jnedbal/TCXOsource/TCXOsource.pdf

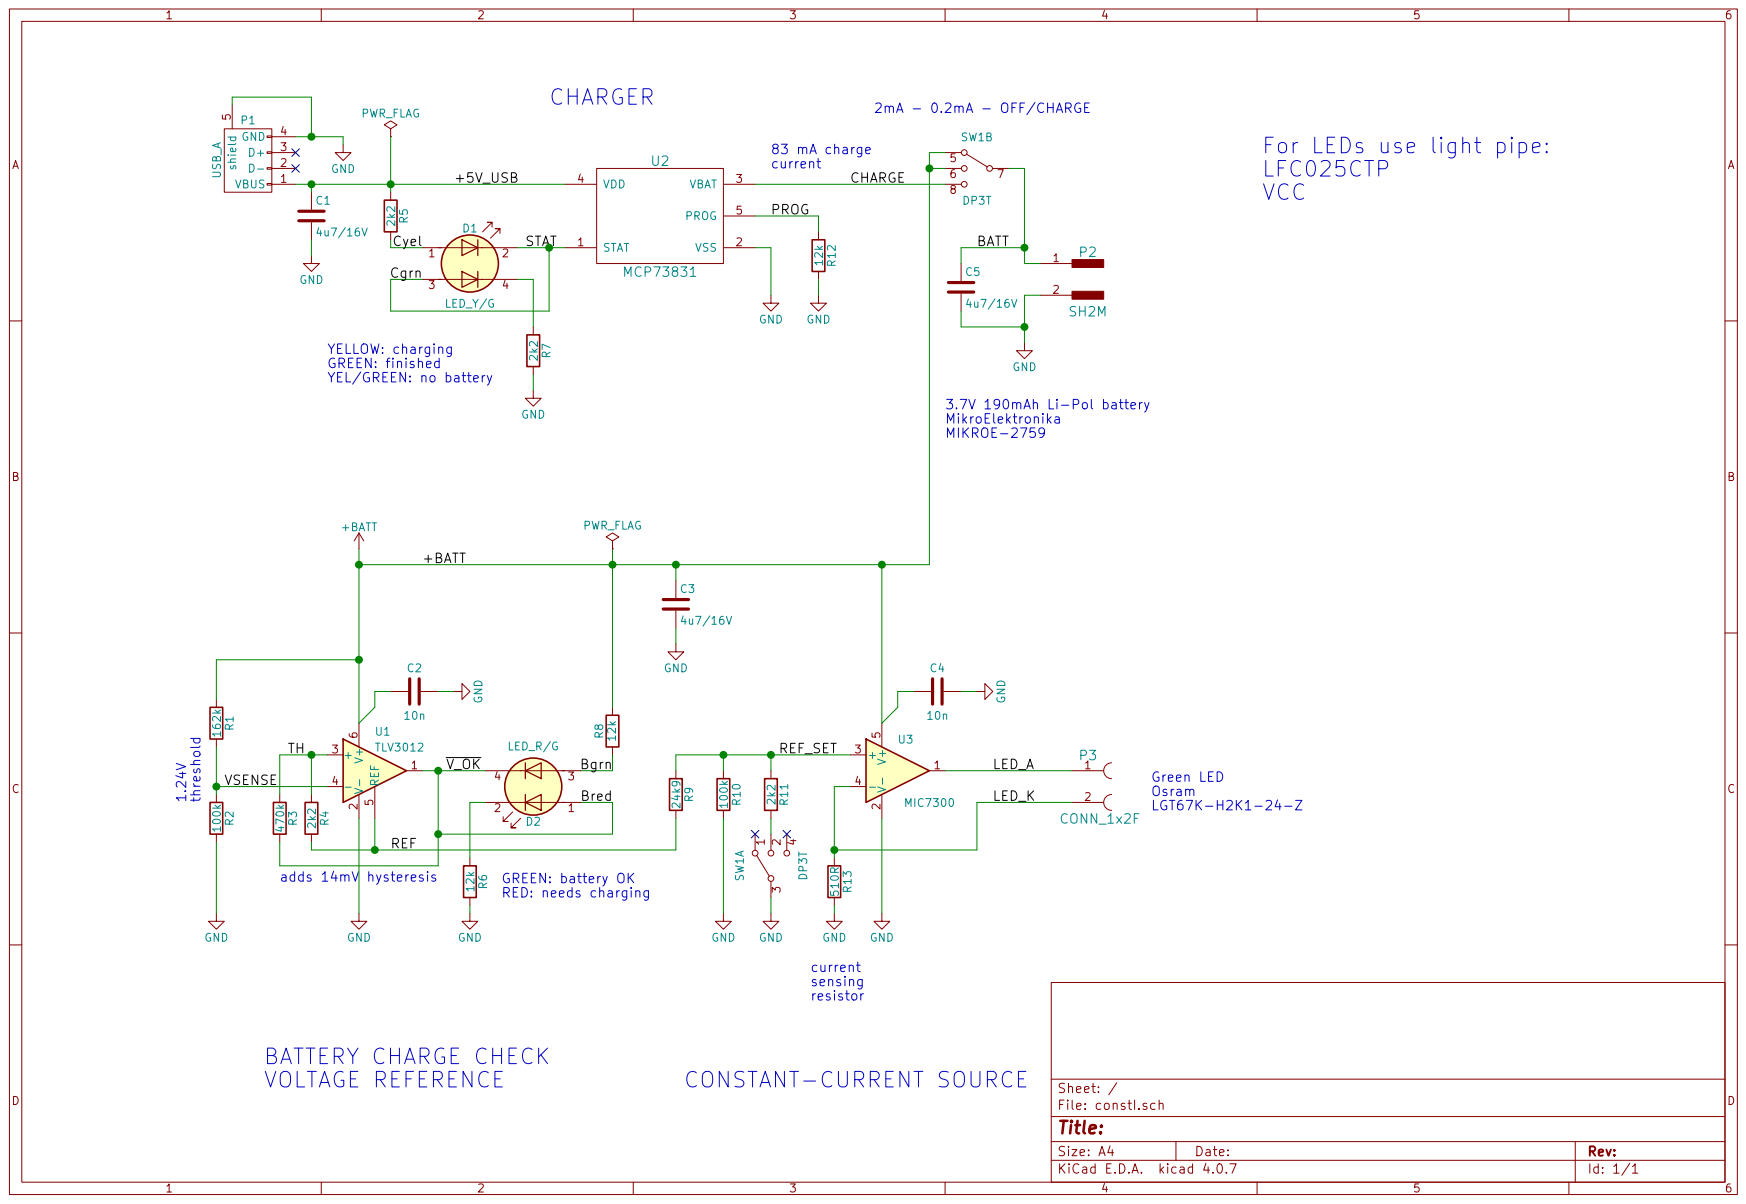
[picture p1: page 1]
