jnedbal/TCXOsource/TCXOsource.kicad_pcb

## KiCad design TCXOsource.kicad_pcb (2019-06-16)

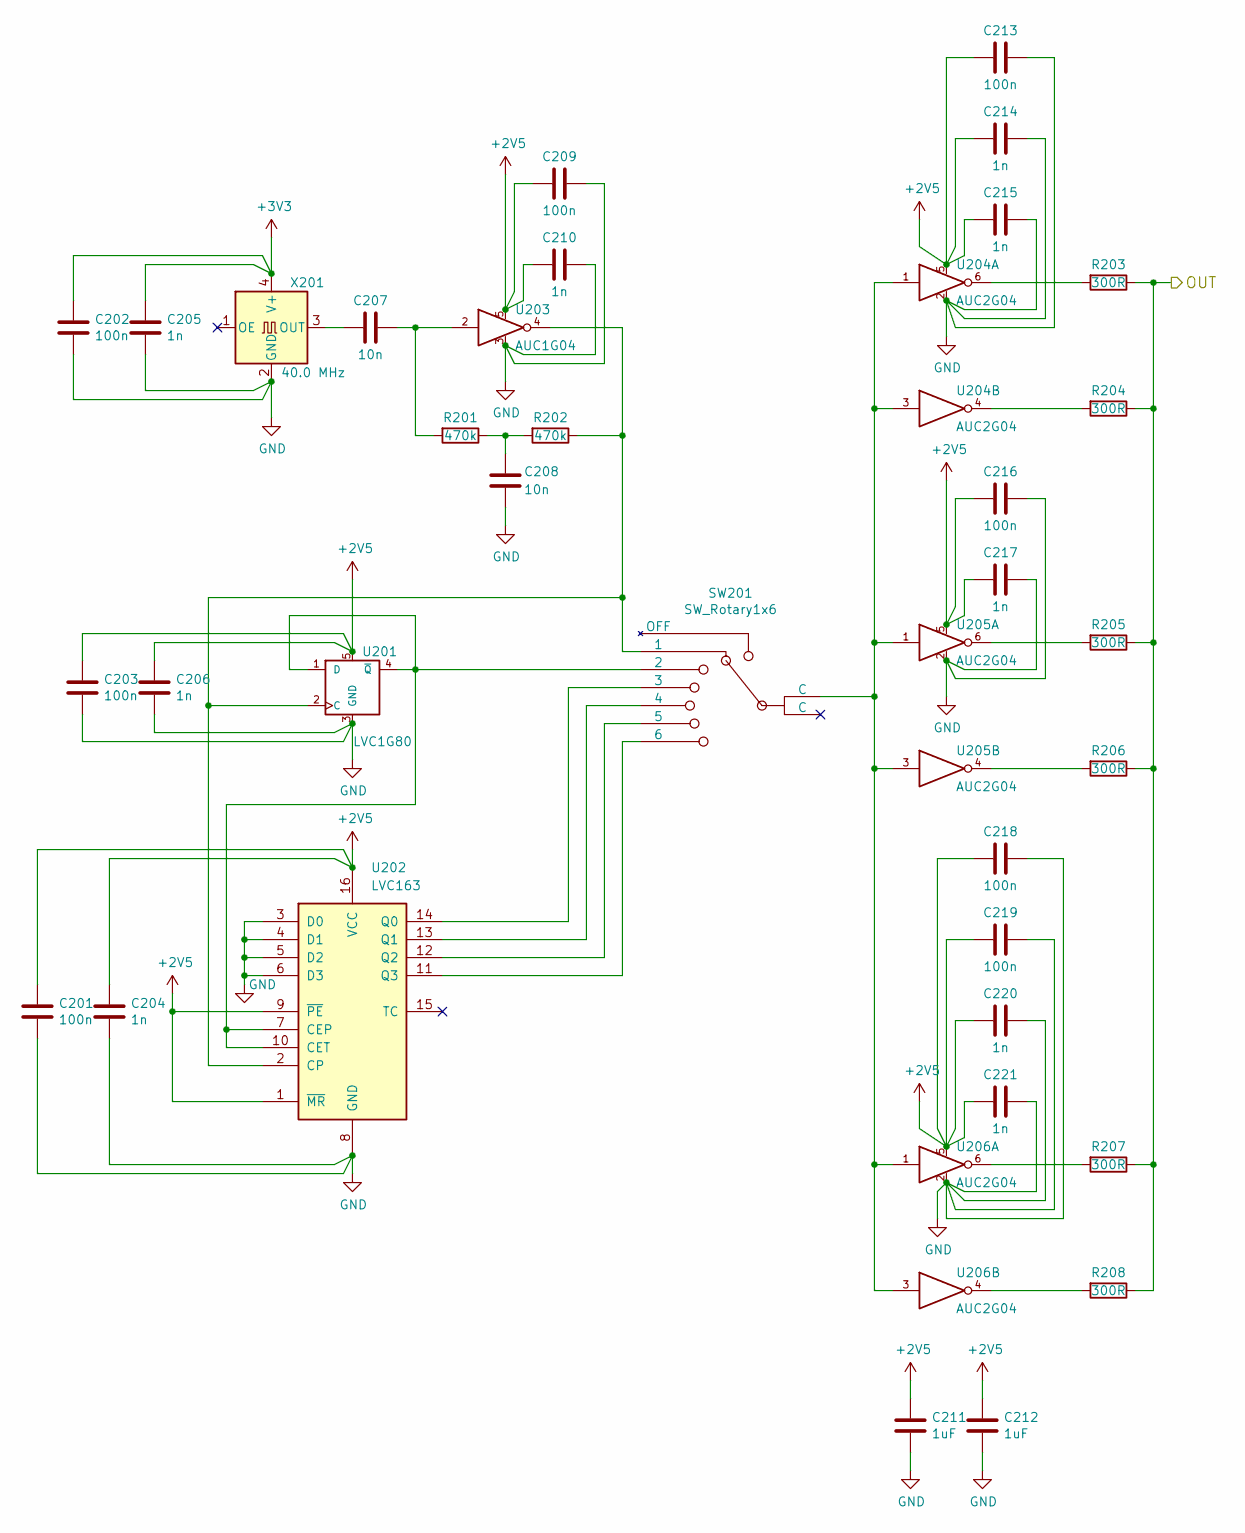
[picture p2: schematic TCXO.sch, TCXO clock source]

Parts:
C201, C202, C203, C209, C213, C216, C218, C219: 100n; C_0603_1608Metric; Part Number MC0603B104K500
C204, C205, C206, C210, C214, C215, C217, C220, C221: 1n; C_0402_1005Metric; Part Number GRM1555C1H102JA01D
C207, C208: 10n; C_0603_1608Metric; Part Number MCU0603R103KCT
C211, C212: 1uF; C_0603_1608Metric; Part Number CGA3E1X7R1C105M080AC
R201, R202: 470k; R_0603_1608Metric; Part Number MCMR06X4703FTL
R203, R204, R205, R206, R207, R208: 300R; R_0402_1005Metric; Part Number MCWR04X3000FTL
SW201: SW_Rotary1x6; Nidec_Copal_SS-10-16
U201: LVC1G80; TSOP-5_1.65x3.05mm_P0.95mm; Part Number 74LVC1G80GV,125
U202: LVC163; TSSOP-16_4.4x5mm_P0.65mm; Part Number 74LVC163PW,118
U203: AUC1G04; SOT-353_SC-70-5_Handsoldering; Part Number SN74AUC1G04DCKR
U204: AUC2G04; SOT-363_SC-70-6_Handsoldering
U205, U206: AUC2G04; SOT-363_SC-70-6_Handsoldering; Part Number SN74AUC2G04DCKR
X201: 40.0 MHz; Oscillator_SMD_EuroQuartz_XO32-4Pin_3.2x2.5mm_HandSoldering; Part Number I537-2P3-40.0000MHZ

Connections:
+2V5: C201.2, C203.2, C204.2, C206.2, C209.2, C210.1, C211.1, C212.1, C213.2, C214.1, C215.1, C216.2, C217.1, C218.2, C219.2, C220.1, C221.1, U201.5, U202.1 (~MR), U202.9 (~PE), U202.16 (VCC), U203.5, U204.5, U205.5, U206.5; also elsewhere on the board
+3V3: C202.2, C205.2, X201.4 (V+); also elsewhere on the board
/TCXO/OUT: R203.1, R204.1, R205.1, R206.1, R207.1, R208.1; also elsewhere on the board
GND: C201.1, C202.1, C203.1, C204.1, C205.1, C206.1, C208.2, C209.1, C210.2, C211.2, C212.2, C213.1, C214.2, C215.2, C216.1, C217.2, C218.1, C219.1, C220.2, C221.2, U201.3 (GND), U202.3 (D0), U202.4 (D1), U202.5 (D2), U202.6 (D3), U202.8 (GND), U203.3, U204.2, U205.2, U206.2, X201.2 (GND); also elsewhere on the board
unnamed: C207.1, R201.2, U203.2
unnamed: C207.2, X201.3 (OUT)
unnamed: C208.1, R201.1, R202.2
unnamed: R202.1, SW201.1, U201.2 (C), U202.2 (CP), U203.4
unnamed: R203.2, U204.6
unnamed: R204.2, U204.4
unnamed: R205.2, U205.6
unnamed: R206.2, U205.4
unnamed: R207.2, U206.6
unnamed: R208.2, U206.4
unnamed: SW201.3 (2), U201.1 (D), U201.4 (~Q), U202.7 (CEP), U202.10 (CET)
unnamed: SW201.4 (3), U202.14 (Q0)
unnamed: SW201.5 (4), U202.13 (Q1)
unnamed: SW201.6 (5), U202.12 (Q2)
unnamed: SW201.7 (C), U204.1, U204.3, U205.1, U205.3, U206.1, U206.3
unnamed: SW201.8 (6), U202.11 (Q3)

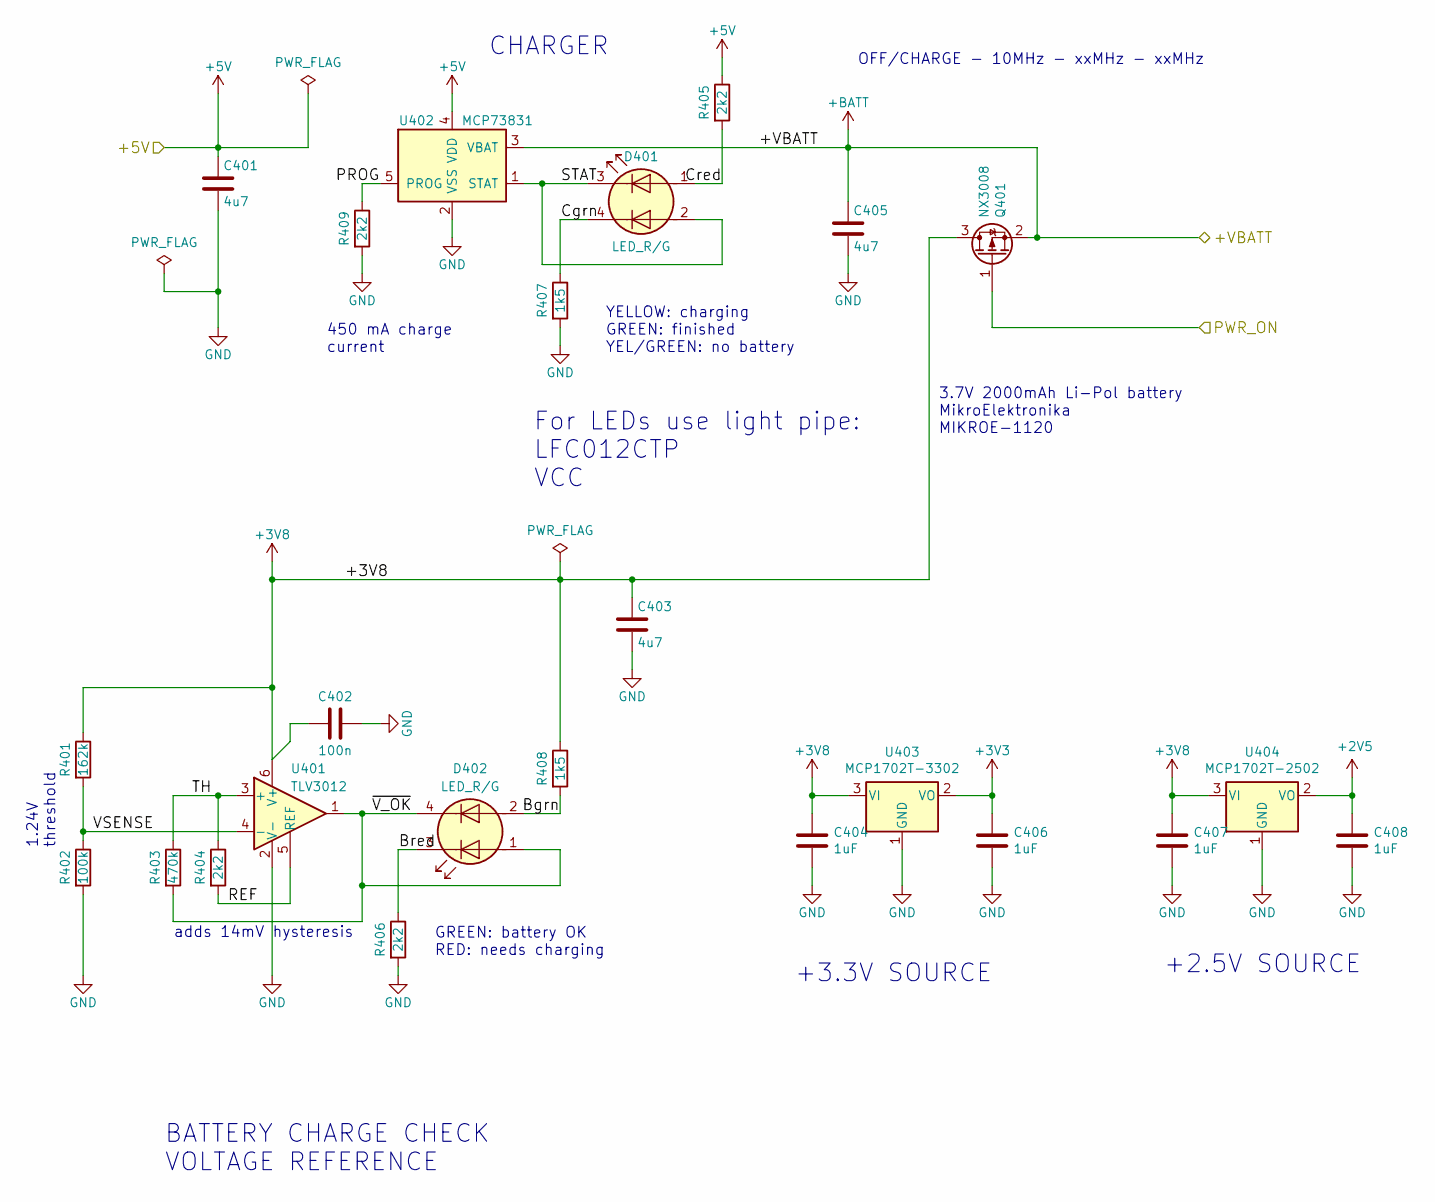
[picture p3: schematic charger.sch, TCXO clock source]

Parts:
C401, C403, C405: 4u7; C_0603_1608Metric; Part Number EMK107ABJ475KA-T
C402: 100n; C_0603_1608Metric; Part Number MC0603B104K500
C404, C406, C407, C408: 1uF; C_0603_1608Metric; Part Number CGA3E1X7R1C105M080AC
D401, D402: LED_R/G; LEDdual_3.2x2.8; Part Number 150141RV73100
Q401: NX3008; SOT-23; Part Number NX3008PBK,215
R401: 162k; R_0603_1608Metric; Part Number CRCW0603162KFKEA
R402: 100k; R_0603_1608Metric; Part Number MCWR06X1003FTL
R403: 470k; R_0603_1608Metric; Part Number MCMR06X4703FTL
R404, R405, R406, R409: 2k2; R_0603_1608Metric; Part Number MCWR06X2201FTL
R407, R408: 1k5; R_0603_1608Metric; Part Number MCWR06X1501FTL
U401: TLV3012; SOT-23-6; Part Number TLV3012AIDBVR
U402: MCP73831; SOT-23-5; Part Number MCP73831T-2DCI/OT
U403: MCP1702T-3302; SOT-23; Part Number MCP1702T-3302E/CB
U404: MCP1702T-2502; SOT-23; Part Number MCP1702T-2502E/CB

Connections:
+2V5: C408.1, U404.2 (VO); also elsewhere on the board
+3V3: C406.1, U403.2 (VO); also elsewhere on the board
+3V8: C402.2, C403.1, C404.1, C407.1, Q401.3 (D), R401.1, R408.1, U401.6 (V+), U403.3 (VI), U404.3 (VI)
+5V: C401.1, R405.1, U402.4 (VDD); also elsewhere on the board
+BATT: C405.1, Q401.2 (S), U402.3 (VBAT); also elsewhere on the board
/Charger & Power Supply/Bgrn: D402.2 (A2), R408.2
/Charger & Power Supply/Bred: D402.3 (K1), R406.1
/Charger & Power Supply/Cgrn: D401.4 (K2), R407.1
/Charger & Power Supply/Cred: D401.1 (A1), R405.2
/Charger & Power Supply/PROG: R409.1, U402.5 (PROG)
/Charger & Power Supply/REF: R404.2, U401.5 (REF)
/Charger & Power Supply/STAT: D401.2 (A2), D401.3 (K1), U402.1 (STAT)
/Charger & Power Supply/TH: R403.1, R404.1, U401.3 (+)
/Charger & Power Supply/VSENSE: R401.2, R402.1, U401.4 (-)
/Charger & Power Supply/~V_OK: D402.1 (A1), D402.4 (K2), R403.2, U401.1
/switch/POWER_ON: Q401.1 (G); also elsewhere on the board
GND: C401.2, C402.1, C403.2, C404.2, C405.2, C406.2, C407.2, C408.2, R402.2, R406.2, R407.2, R409.2, U401.2 (V-), U402.2 (VSS), U403.1 (GND), U404.1 (GND); also elsewhere on the board

Notes on the sheet:
adds 14mV hysteresis
1.24V threshold
3.7V 2000mAh Li-Pol battery MikroElektronika MIKROE-1120
450 mA charge current
OFF/CHARGE - 10MHz - xxMHz - xxMHz
YELLOW: charging GREEN: finished YEL/GREEN: no battery
GREEN: battery OK RED: needs charging
CHARGER
BATTERY CHARGE CHECK VOLTAGE REFERENCE
+3.3V SOURCE
For LEDs use light pipe: LFC012CTP VCC
+2.5V SOURCE

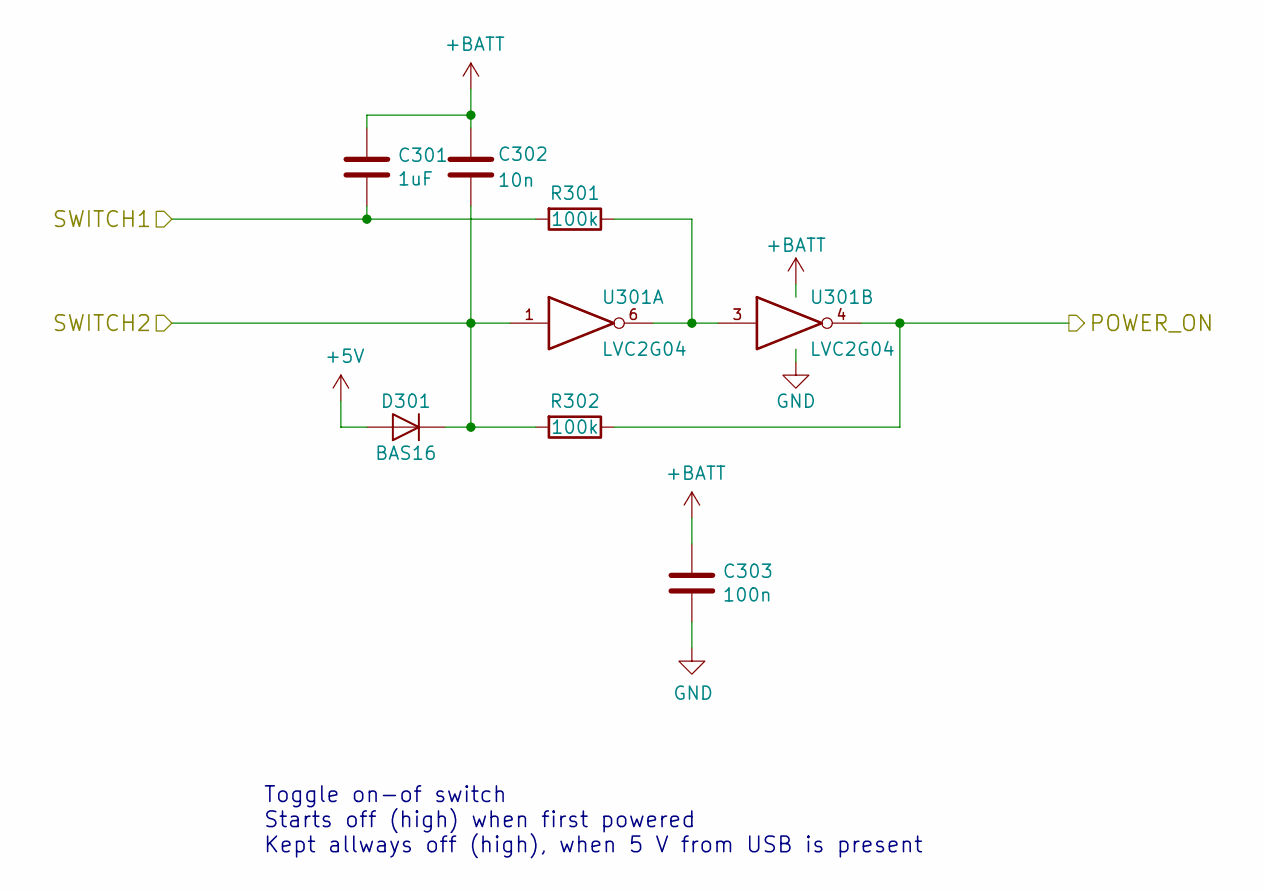
[picture p4: schematic switch.sch, TCXO clock source]

Parts:
C301: 1uF; C_0603_1608Metric; Part Number CGA3E1X7R1C105M080AC
C302: 10n; C_0603_1608Metric; Part Number MCU0603R103KCT
C303: 100n; C_0603_1608Metric; Part Number MC0603B104K500
D301: BAS16; D_SOD-323_HandSoldering; Part Number BAS16HT1G
R301, R302: 100k; R_0603_1608Metric; Part Number MCWR06X1003FTL
U301: LVC2G04; SOT-23-6; Part Number SN74LVC2G04DBVR

Connections:
+5V: D301.2 (A); also elsewhere on the board
+BATT: C301.1, C302.1, C303.2, U301.5 (VCC); also elsewhere on the board
/SWITCH1: C301.2, R301.2; also elsewhere on the board
/SWITCH2: C302.2, D301.1 (K), R302.2, U301.1; also elsewhere on the board
/switch/POWER_ON: R302.1, U301.4; also elsewhere on the board
GND: C303.1, U301.2 (GND); also elsewhere on the board
unnamed: R301.1, U301.3, U301.6

Notes on the sheet:
Toggle on-of switch Starts off (high) when first powered Kept allways off (high), when 5 V from USB is present

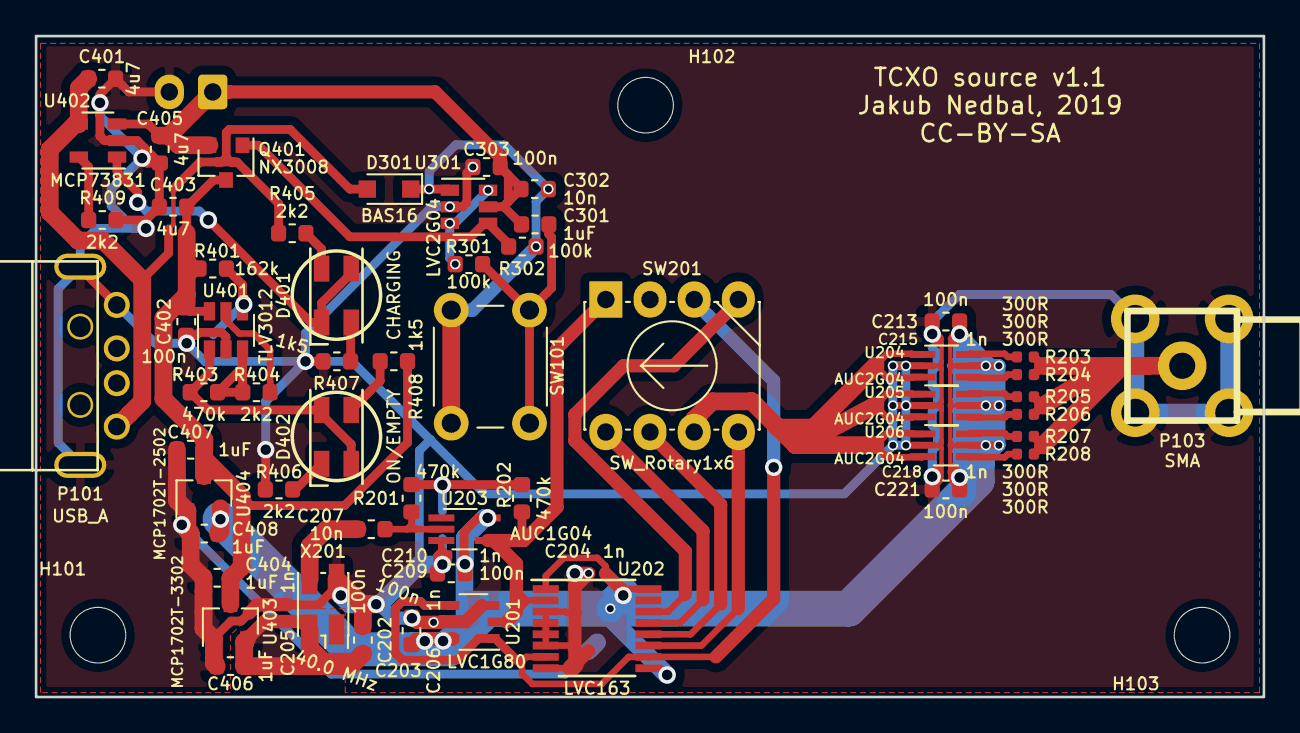
[picture p5: board TCXOsource.kicad_pcb from above]

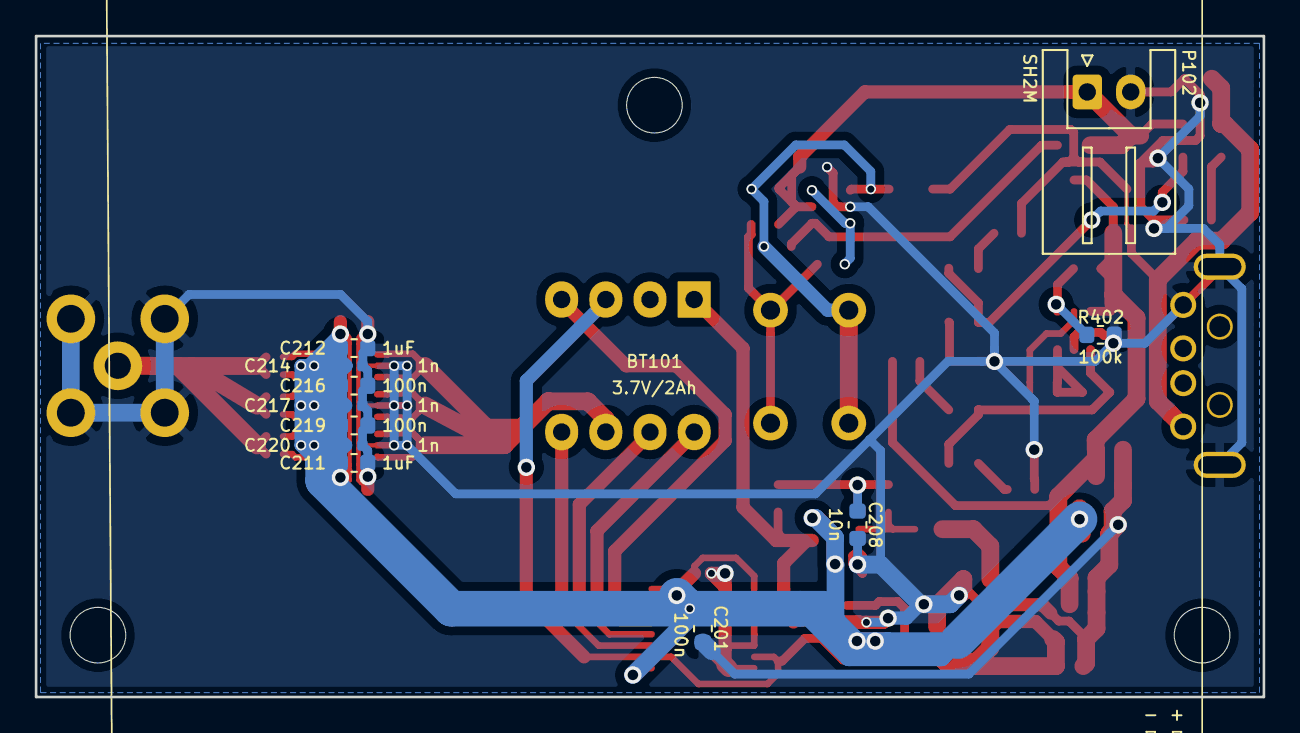
[picture p6: board TCXOsource.kicad_pcb from below]

Board: 2 copper layers, 70.6 x 38.0 mm, 76 parts (12 on the bottom side), 37 nets.

Other parts of the board:
BT101: 3.7V/2Ah; MIKROE-1120
H101, H102, H103: MountingHole; MountingHole_3.2mm_M3
P101: USB_A; Molex_USB_A
P102: SH2M; JST_XH_S2B-XH-A_1x02_P2.50mm_Horizontal
P103: SMA
SW101: SW_Push; SW_PUSH_6mm_H13mm

Their connections:
+5V: P101.1; also elsewhere on the board
+BATT: P102.1; also elsewhere on the board
/SWITCH1: SW101.2; also elsewhere on the board
/SWITCH2: SW101.1; also elsewhere on the board
/TCXO/OUT: P103.1; also elsewhere on the board
GND: P101.4, P101.5, P102.2, P103.2, P103.3, P103.4, P103.5; also elsewhere on the board
