jnedbal/TCXOsource/(commit log)

2019-06-16 Initial commit. Sent for manufacture.
    [TCXO.sch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]
2019-07-16 Updated several part details with alternative suppliers
    [TCXO.sch, TCXOsourcegrouped.csv, charger.sch, switch.sch]
