jnedbal/TCXOsource/(notices)

Notices in the files:
TCXOsource.kicad_pcb:
CC-BY-SA
